fvilmos/power_meter_mqtt/images/ds18b20_connection.png

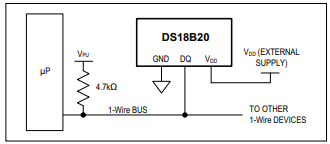
images/ds18b20_connection.png
