fvilmos/power_meter_mqtt/(threads)

Thread 2 (2022-12-11):

Is it correct?

jaroslavas, 2022-12-11:
Are you sure it works properly? Looking at `void IRAM_ATTR isr()` function, it takes the time of the first pulse, then waits for the seconds and counts power. This part looks ok. Then after power is counted, it sets `bPulseDetected` to `false`. This means, that when third pulse comes, it doesn't count the power, only starts waiting for the fourth pulse. Looks like it should miss about half of power consumption this way.
Am I missing something?

fvilmos, 2022-12-17:
The esp32 chip has some hw bugs (https://www.espressif.com/sites/default/files/documentation/esp32_errata_en.pdf), see section 3.14 for the isr issue. This is whay the implementation was done as it is. I do not have an oscilloscope to  test this, maybe you have.

jaroslavas, 2022-12-17:
No I don't, but after a month of using it reported me less kWh than the power meter itself. I've made some changes in code and now after a week it shows exactly the same number as the meter itself :) I can make a pull request if you are interested.

fvilmos, 2022-12-17:
Sounds great, please do a pull request.

SleepyBear-Ship-It, 2023-06-05:
@jaroslavas i'm interested to as im seeing the same, if you have some improvements please share :)
@fvilmos thank you for your work, the power monitoring is really nice.

jaroslavas, 2023-07-02:
@SleepyBear-Ship-It I finally found time to push these few lines of code :D
https://github.com/fvilmos/power_meter_mqtt/pull/4

fvilmos, 2023-07-02:
@jaroslavas, thanks for your contribution!

Closed 2023-07-02.

Thread 3 (2023-03-03):

[SOLVED] Constantly 1800W?

zeirix, 2023-03-03:
Hi,

thank you for the cool project!

I managed it to run it on a WT32-ETH01 Board (using Ethernet), it is sending MQTT packages as expected.
Only the readout is constantly 1800W, no matter what's happening (Hi/Lo) on Pin 18 (According to IO4 on my board).
These would be 2 pulses/second (my counter has a `PULSES_KWH_RES 1`).

Do you know a bug or a process, which could trigger the Interrupt exactly two times a second?

Thank You!

zeirix, 2023-03-03:
Sorry for the disturbance.
By accident I figured out, that the Pin numbering is according to the numbering on the board (yes, I'm a ESP32 newbie).
Using `#define IN_PIN_PEM 4` solved the issue.
Have a nice day!

fvilmos, 2023-03-07:
Hello Zeirix, great that is working now!

Closed 2023-03-07.

Thread 5 (2023-09-29):

DHT22 support

iLLiac4, 2023-09-29:
Hi.
Would it be possible to add DHT22 support?
And also yearly usage.

TNX

iLLiac4, 2023-09-30:
I have few other questions:
1. What happens if wifi is lost?
2. Is there a reset button to zero it? Similar to this one https://github.com/oh2mp/esp32_energymeter ?
TNX

fvilmos, 2023-10-01:
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

Hello iLLiac4,

1. if wifi is not available on start-up , the SW will wait until can connect.
  /*Wait for connection*/
  while (WiFi.status() != WL_CONNECTED)
  {
    delay(500);
#ifdef DEBUG
    Serial.print(".");
#endif

  }
1.1 on mqtt loss, the system waits 3s than tryes to reconnect on wifi + mqtt

  /*reconect on Mqtt loss*/
  if (client.state()< 0)
  {
    #ifdef DEBUG
    Serial.println("No MQTT Connection, reconnect");
    #endif

    delay (3000);
    setup();
   ...

2. thre is no physical reset button, if is the case I just plug out the USB cable than reconnect it.

fvilmos, 2023-10-01:
> Hi. Would it be possible to add DHT22 support? And also yearly usage.
>
> TNX

DHT22 seams to be possible trough the DHT library, unfortunately I do have such a sensor, therefore, I would not be able to test it. Would it be great if you could implement it on a fork, then merge it with this.
Yearly usage was on in my plan, I need to analyze if it would be possible to add.

Regards.

Thread 6 (2023-10-01):

Schrack mgrzk465

iLLiac4, 2023-10-01:
Hi. I need some help.
Want to add this meter to HomeAssistant and am having problems.
Those are impulse specs:
Pulsfrequenz: 1000 imp/kWh
Impulsdauer: 32 ms ±2 ms
Bemessungsspannung DC: 27 V max
Schaltstrom: 27 mA max

I was able to program the microcontroller and i am able to ping it.
Have changed in .ino file:
#define IN_PIN_PEM 18             /* input pin for pulse sensor */
#define IN_PIN_TMP 2              /* input pin for DS18d20 temperature sensor */
#define ISR_TYPE FALLING          /* isr triggering mode */
#define HOUR 3600.0               /* hour as constant */
#define PULSES_KWH_RES 1         /* 1 KW = 1000W, power meter has 2000 (0.5) inpulses resolution */
#define SECOUND_ISR_PERIOD 0.032   /* pulse period is ~90 ms (32ms), used to ignore secound interrupt arrival bug*/
#define MAX_POWER 7040            /* for a peek of 32A => 7040W, ignor higher measurements */

And I get nothing. Also have problems with HomeAssitant I can not get this MQTT working. _Have mosquito installed also devices from Tasmota are working ok. Have paste the config into .yaml and nothing.
I am using [ESP32 WeMos LOLIN32 Lite](https://mischianti.org/2021/07/30/esp32-wemos-lolin32-lite-high-resolution-pinout-and-specs/). But it is the same as yours basically.

fvilmos, 2023-10-01:
Hello,
did you tried to connect trough Arduino studio and enable the debug function (add to the .ino file: #define DEBUG)?
If this enabled, you will get in serial terminal the debug messages...

Verify:
1. wifi connected
2. mosquito connected, Does your mosquito needs a password on connection?
3. use an mqtt web client to inspect the communication.
